HandHeldLegend/GC-Ultimate/HW/Projects/Trigger Hall FPC/FPC_Trigger_Board.kicad_pcb

## KiCad design HW/Projects/Trigger Hall FPC/FPC_Trigger_Board.kicad_pcb (2025-12-12)

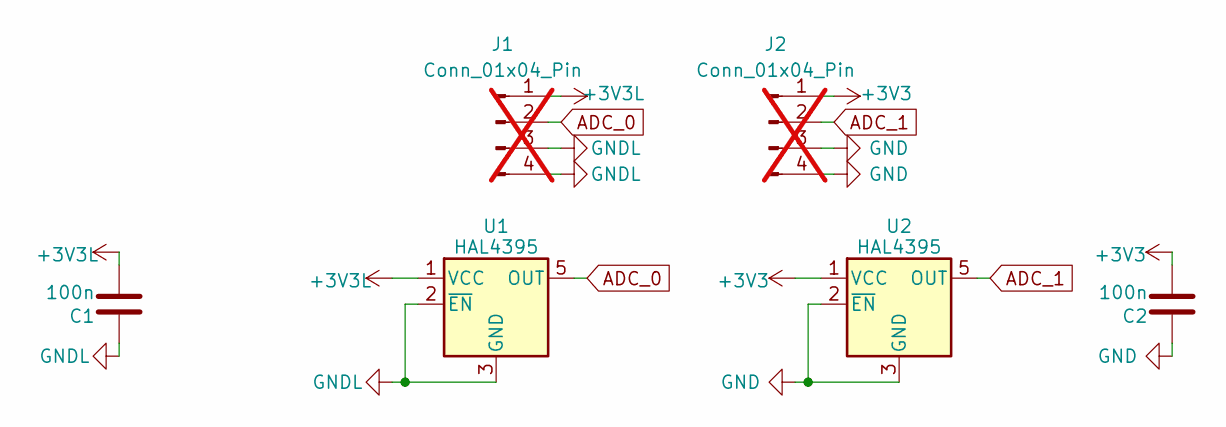
[picture p9: schematic FPC_Trigger_Board.kicad_sch, GCU Hall Trigger]

Parts:
C1, C2: 100n; C_0201_0603Metric; MPN GRM033R61A104KE15D; LCSC C76934
J1, J2: Conn_01x04_Pin; 505110-0492 Ribbon; not fitted
U1, U2: HAL4395; SOT-23-5L; MPN HAL4395SO5; LCSC C49165022

Connections:
+3V3: C2.2, J2.1, U2.1 (VCC)
+3V3L: C1.2, J1.1, U1.1 (VCC)
ADC_0: J1.2, U1.5 (OUT)
ADC_1: J2.2, U2.5 (OUT)
GND: C2.1, J2.3, J2.4, U2.2 (~EN), U2.3 (GND)
GNDL: C1.1, J1.3, J1.4, U1.2 (~EN), U1.3 (GND)

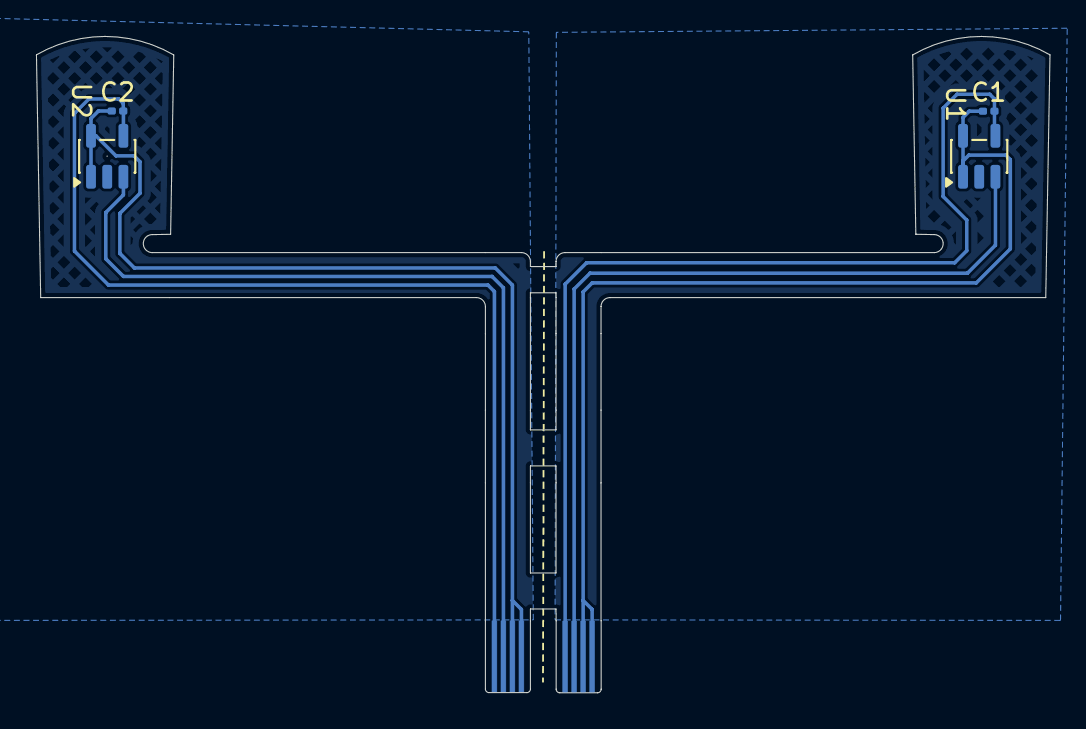
[picture p10: board FPC_Trigger_Board.kicad_pcb from below]

Board: 2 copper layers, 56.3 x 36.5 mm, 6 parts (4 on the bottom side), 6 nets.
