HandHeldLegend/GC-Ultimate/HW/Projects/Main_R4K/UGC_Main_R4K.kicad_pcb

## KiCad design HW/Projects/Main_R4K/UGC_Main_R4K.kicad_pcb (2025-09-02)

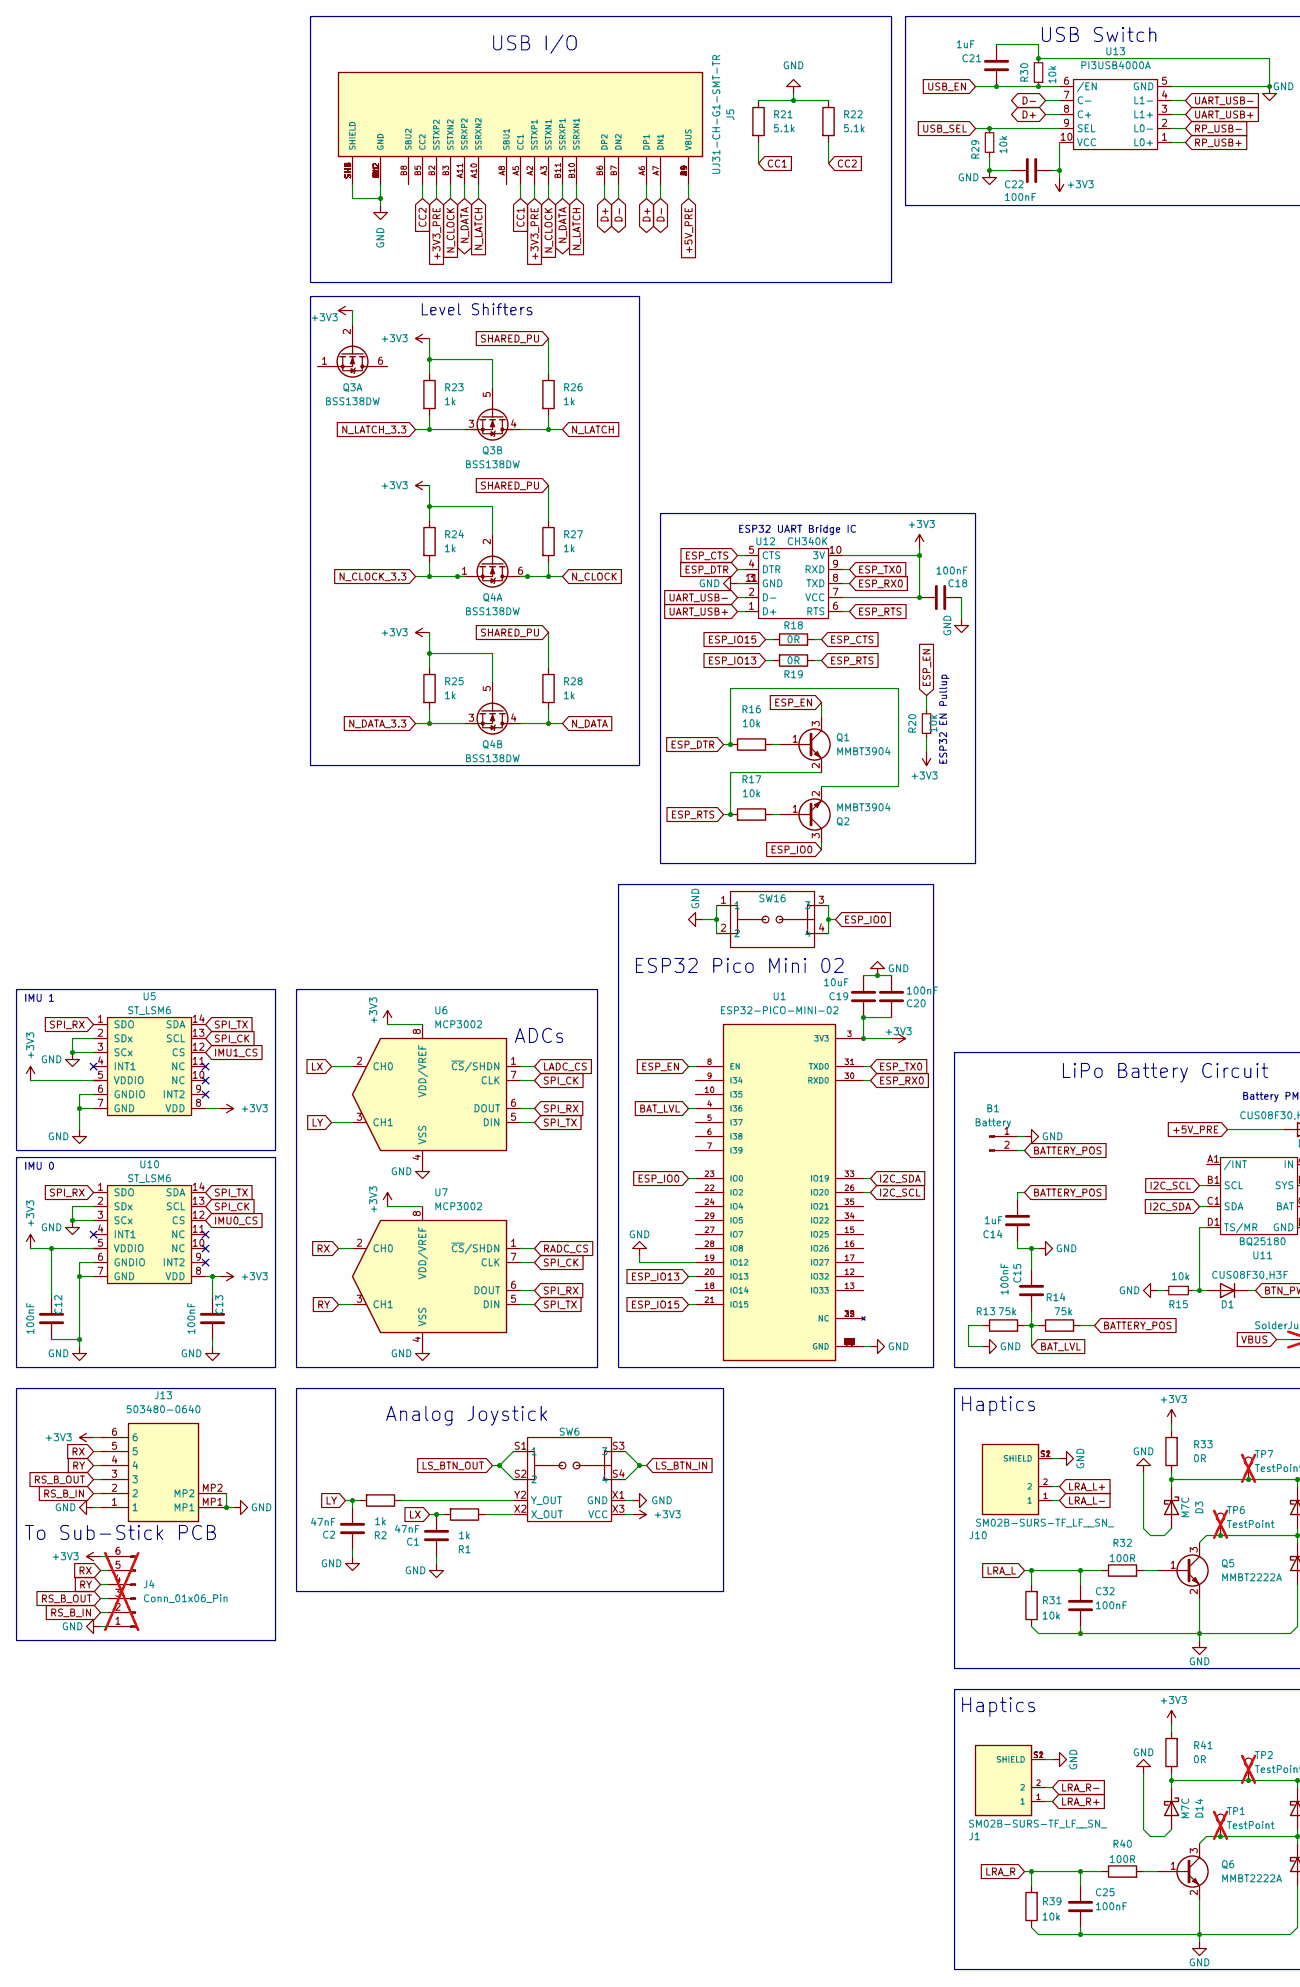
[picture p11: schematic UGC_Main_R4K.kicad_sch, GC Ultimate R4K, part in row 1, column 1]

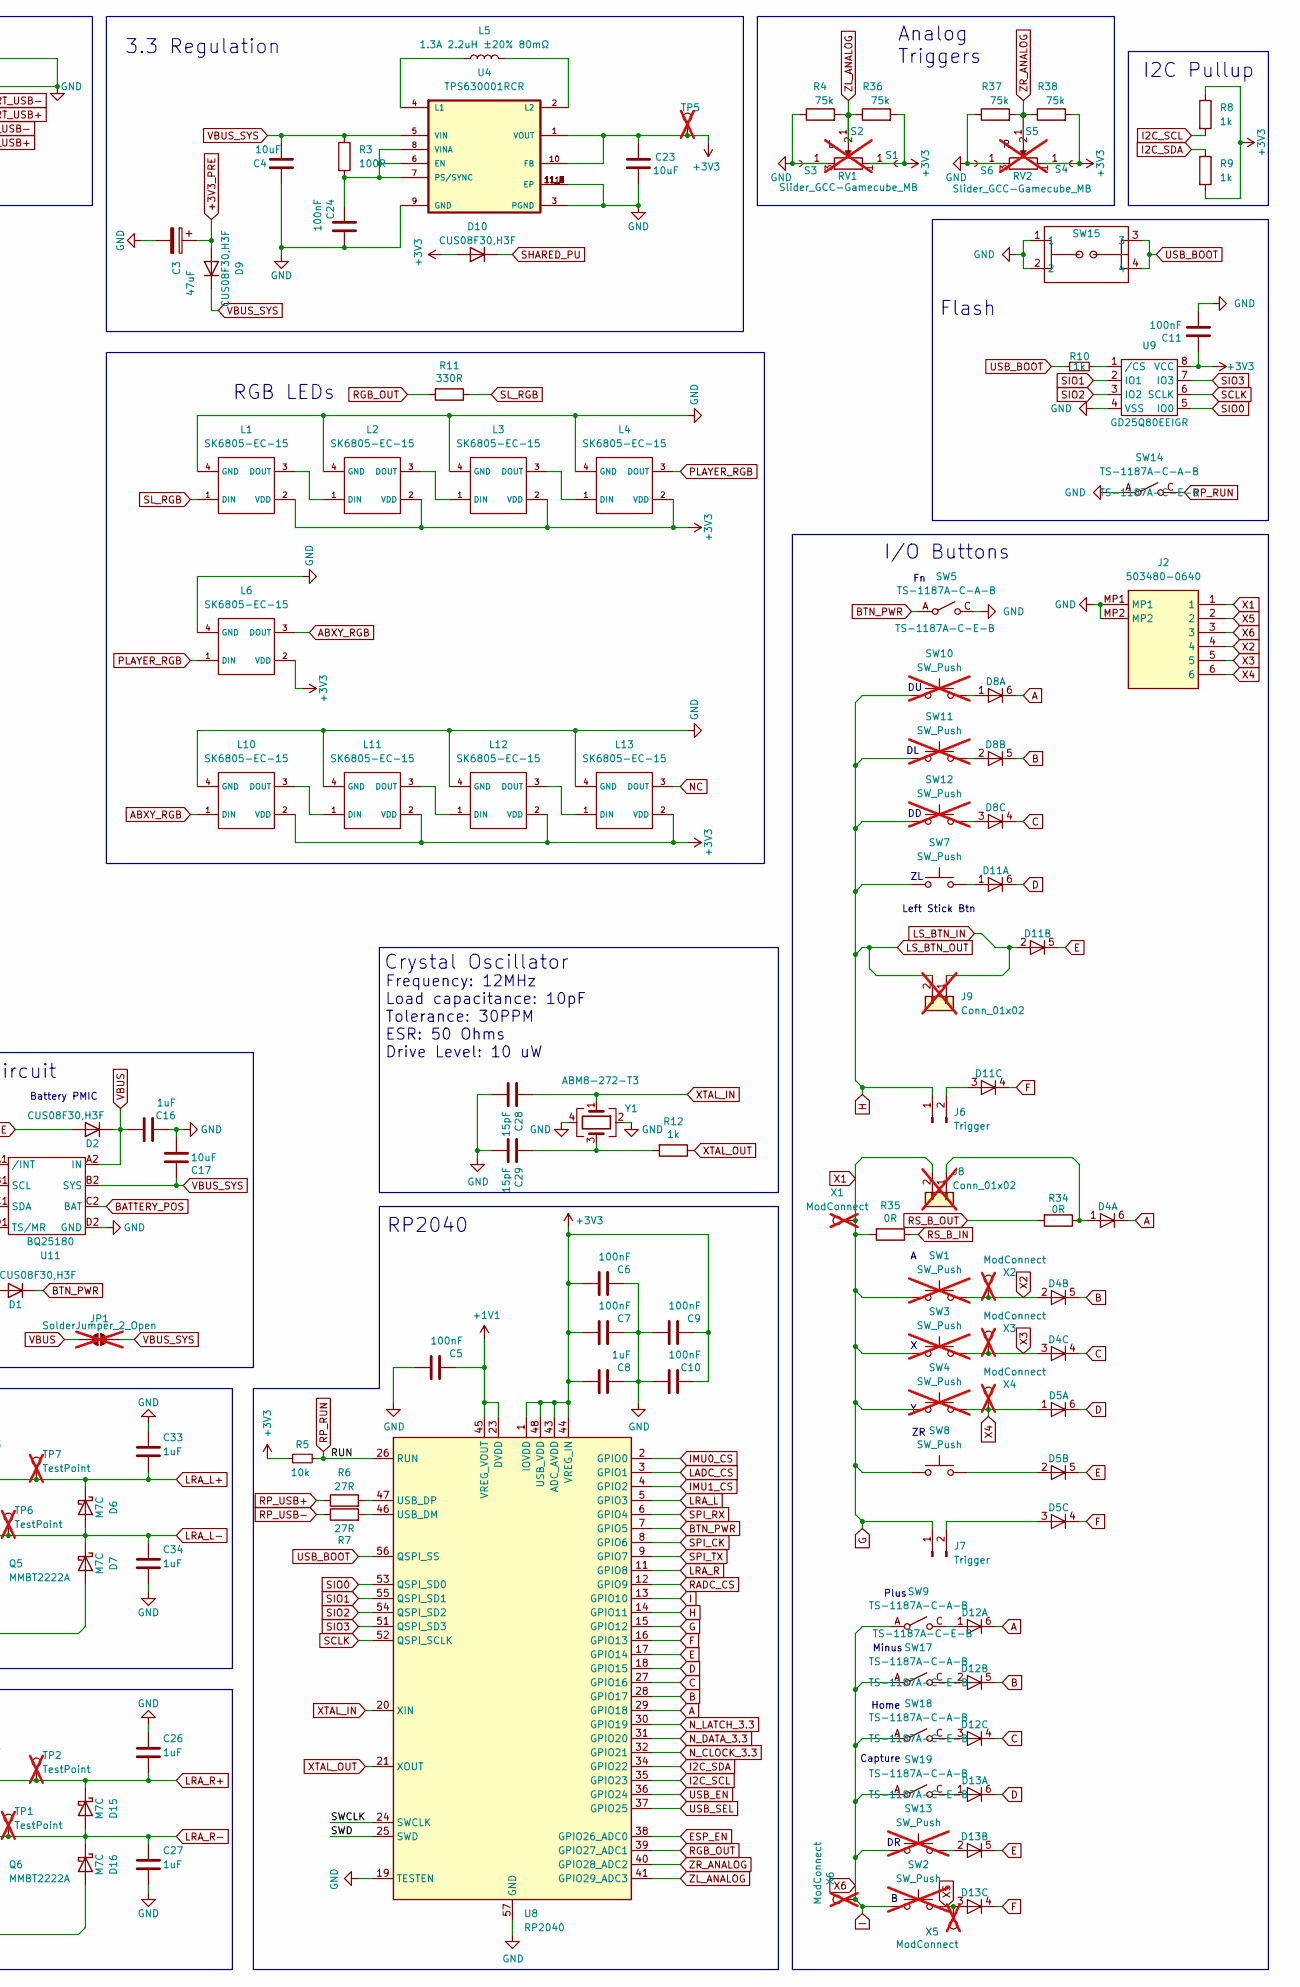
[picture p12: schematic UGC_Main_R4K.kicad_sch, GC Ultimate R4K, part in row 1, column 2]

Parts:
B1: Battery; JST_PH_B2B-PH-K_1x02_P2.00mm_Vertical; MPN HDGC2001WV-2P; LCSC C5175230
C1, C2: 47nF; C_0603_1608Metric; MPN CC0603JRX7R9BB473; LCSC C519554
C3: 47uF; CP_EIA-3216-18_Kemet-A; MPN TAJA476K006RNJ; LCSC C7190
C4, C17, C19, C23: 10uF; C_0805_2012Metric; MPN CL21A106KPFNNNE; LCSC C17024
C5, C6, C7, C9, C10, C11, C12, C13, C15, C18, C20, C22, C24, C25, C32: 100nF; C_0201_0603Metric; MPN CL03A104KQ3NNNC; LCSC C160831
C8, C14, C16, C21, C26, C27, C33, C34: 1uF; C_0201_0603Metric; MPN GRM033R60J105KEA2D; LCSC C76929
C28, C29: 15pF; C_0402_1005Metric; MPN CC0402FRNPO9BN150; LCSC C326803
D1, D2, D9, D10: CUS08F30,H3F; D_SOD-323_HandSoldering; MPN CUS08F30,H3F; LCSC C150183
D3, D6, D7, D14, D15, D16: M7C; D_SOD-523; MPN B5819WT; LCSC C5364321
D4, D5, D8, D11, D12, D13: BAS16VY,115; SOT-363_SC-70-6; MPN BAS16VY,115; LCSC C135826
J1, J10: SM02B-SURS-TF_LF__SN_; JST_SM02B-SURS-TF_LF__SN_; PARTREV N/A; LCSC C566239
J2, J13: 503480-0640; 5034800640; Mouser Part Number 538-503480-0640
J4: Conn_01x06_Pin; PinHeader_1x06_P2.00mm_Vertical; MPN N/A; not fitted
J5: UJ31-CH-G1-SMT-TR; CUI_UJ31-CH-G1-SMT-TR; PART_REV 1.01; LCSC C22359729
J6, J7: Trigger; JST_PH_B2B-PH-K_1x02_P2.00mm_Vertical; MPN HDGC2001WV-2P; LCSC C5175230
J8, J9: Conn_01x02; PinHeader_1x02_P2.00mm_Vertical; MPN N/A; not fitted
JP1: SolderJumper_2_Open; SolderJumper-2_P1.3mm_Open_Pad1.0x1.5mm; MPN N/A; not fitted
L1, L2, L3, L4, L6, L10, L11, L12, L13: SK6805-EC-15; MPN SK6805-EC-15; LCSC C2890035
L5: 1.3A 2.2uH ±20% 80mΩ; L_1008_2520Metric; MPN MIP25202R2MBE; LCSC C315721
Q1, Q2: MMBT3904; SOT-23; MPN MMBT3904; LCSC C2891808
Q3, Q4: BSS138DW; SOT-363_SC-70-6; MPN BSS138DW-7-F; LCSC C154900
Q5, Q6: MMBT2222A; SOT-23; MPN MMBT2222A; LCSC C916372
R1, R2, R8, R9, R10, R12, R23, R24, R25, R26, R27, R28: 1k; R_0201_0603Metric; MPN RC0201FR-071KL; LCSC C138165
R3, R32, R40: 100R; R_0201_0603Metric; MPN RC0201FR-07100RL; LCSC C77623
R4, R13, R14, R36, R37, R38: 75k; R_0201_0603Metric; MPN AF0201FR-0775KL; LCSC C2107901
R5, R15, R16, R17, R20, R29, R30, R31, R39: 10k; R_0201_0603Metric; MPN RC0201FR-0710KL; LCSC C106225
R6, R7: 27R; R_0201_0603Metric; MPN RC0201FR-0727RL; LCSC C273268
R11: 330R; R_0201_0603Metric; MPN RC0201FR-07330RL; LCSC C274872
R18, R19, R33, R34, R35, R41: 0R; R_0201_0603Metric; MPN RC0201FR-070RL; LCSC C106227
R21, R22: 5.1k; R_0201_0603Metric; MPN RC0201FR-075K1L; LCSC C274341
RV1, RV2: Slider_GCC-Gamecube_MB; GCC_Slider_MillMaxSocketed; MPN RD7091008A; not fitted
S1, S2, S3, S4, S5, S6: 4015-0-43-80-30-27-10-0; MPN 4015-0-43-80-30-27-10-0; LCSC C17526581
SW1, SW2, SW3, SW4: SW_Push; ring_pad; MPN N/A; not fitted
SW5, SW9, SW14, SW17, SW18, SW19: TS-1187A-C-A-B; TS-1187A-C-E-B; MPN TS-1187A-C-E-B; LCSC C480267
SW6: GL18_SW; GL1807SYAE; MPN GL1807SYAE-002
SW7, SW8: SW_Push; Z_Switch_Edge_Omron; MPN TC-00100V H5.0 100gf
SW10, SW11, SW12, SW13: SW_Push; ring_dpad; MPN N/A; not fitted
SW15, SW16: 1TS026A-1000-0550; MPN 1TS026A-1000-0550; LCSC C913778
TP1, TP2, TP6, TP7: TestPoint; TestPoint_Pad_2.0x2.0mm; MPN N/A; not fitted
TP5: TestPoint; TestPoint_Pad_D1.5mm; MPN N/A; not fitted
U1: ESP32-PICO-MINI-02; MODULE_ESP32-PICO-MINI-02; PARTREV v1.0; LCSC C2980306
U4: TPS630001RCR; VREG_V62_16624-01YE; MPN TPS63001DRCR; LCSC C28060
U5, U10: ST_LSM6; LGA14; MPN LSM6DSRTR; LCSC C784817
U6, U7: MCP3002; MSOP-8_3x3mm_P0.65mm; MPN MCP3002-I/MS; LCSC C635958
U8: RP2040; QFN-56-1EP_7x7mm_P0.4mm_EP3.2x3.2mm; MPN RP2040; LCSC C2040
U9: GD25Q80EEIGR; USON-8-EP(2x3); MPN GD25Q80EEIGR; LCSC C2874937
U11: BQ25180; DSBGA; MPN BQ25180; LCSC C3682423
U12: CH340K; ESSOP-10; MPN CH340K; LCSC C968586
U13: PI3USB4000A; Texas_UQFN-10_1.5x2mm_P0.5mm; MPN PI3USB4000AZUAEX; LCSC C294596
X1, X2, X3, X4, X5, X6: ModConnect; TestPoint_Pad_D1.5mm; MPN N/A; not fitted
Y1: ABM8-272-T3; Crystal_SMD_3225-4Pin_3.2x2.5mm; MPN ABM8-272-T3; LCSC C20625731

Connections:
+1V1: C5.2, U8.23 (DVDD), U8.45 (VREG_VOUT), U8.50 (DVDD)
+3V3: C6.1, C7.1, C8.1, C9.2, C10.2, C11.1, C12.2, C13.2, C18.1, C19.1, C20.2, C22.1, C23.1, D10.2 (A), J4.6, J13.6, L1.2 (VDD), L2.2 (VDD), L3.2 (VDD), L4.2 (VDD), L6.2 (VDD), L10.2 (VDD), L11.2 (VDD), L12.2 (VDD), L13.2 (VDD), Q3.2 (G1), Q3.5 (G2), Q4.2 (G1), Q4.5 (G2), R5.1, R8.1, R9.2, R20.1, R23.1, R24.1, R25.1, R33.2, R36.2, R38.2, R41.2, S1.1, S4.1, SW6.X3 (VCC), SW6.Y3 (VCC), TP5.1, U1.3 (3V3), U4.1 (VOUT), U4.10 (FB), U5.5 (VDDIO), U5.8 (VDD), U6.8 (VDD/VREF), U7.8 (VDD/VREF), U8.1 (IOVDD), U8.10 (IOVDD), U8.22 (IOVDD), U8.33 (IOVDD), U8.42 (IOVDD), U8.43 (ADC_AVDD), U8.44 (VREG_IN), U8.48 (USB_VDD), U8.49 (IOVDD), U9.8 (VCC), U10.5 (VDDIO), U10.8 (VDD), U12.7 (VCC), U12.10 (3V), U13.10 (VCC)
+3V3_PRE: C3.1, D9.2 (A), J5.A2 (SSTXP1), J5.B2 (SSTXP2)
+5V_PRE: D2.2 (A), J5.A4 (VBUS), J5.A9 (VBUS), J5.B4 (VBUS), J5.B9 (VBUS)
/SWCLK: U8.24 (SWCLK)
/SWD: U8.25 (SWD)
A: D4.6 (K), D8.6 (K), D12.6 (K), U8.29 (GPIO18)
ABXY_RGB: L6.3 (DOUT), L10.1 (DIN)
B: D4.5 (K), D8.5 (K), D12.5 (K), U8.28 (GPIO17)
BATTERY_POS: B1.2, C14.2, R14.2, U11.C2 (BAT)
BAT_LVL: C15.1, R13.2, R14.1, U1.4 (I36)
BTN_PWR: D1.1 (K), SW5.A, SW5.B, U8.7 (GPIO5)
C: D4.4 (K), D8.4 (K), D12.4 (K), U8.27 (GPIO16)
CC1: J5.A5 (CC1), R21.2
CC2: J5.B5 (CC2), R22.2
D: D5.6 (K), D11.6 (K), D13.6 (K), U8.18 (GPIO15)
D+: J5.A6 (DP1), J5.B6 (DP2), U13.8 (C+)
D-: J5.A7 (DN1), J5.B7 (DN2), U13.7 (C-)
E: D5.5 (K), D11.5 (K), D13.5 (K), U8.17 (GPIO14)
ESP_CTS: R18.2, U12.5 (CTS)
ESP_DTR: Q2.2 (E), R16.1, U12.4 (DTR)
ESP_EN: Q1.3 (C), R20.2, U1.8 (EN), U8.38 (GPIO26_ADC0)
ESP_IO0: Q2.3 (C), SW16.3, SW16.4, U1.23 (IO0)
ESP_IO13: R19.2, U1.20 (IO13)
ESP_IO15: R18.1, U1.21 (IO15)
ESP_RTS: Q1.2 (E), R17.2, R19.1, U12.6 (RTS)
ESP_RX0: U1.30 (RXD0), U12.8 (TXD)
ESP_TX0: U1.31 (TXD0), U12.9 (RXD)
F: D5.4 (K), D11.4 (K), D13.4 (K), U8.16 (GPIO13)
G: J2.1, J7.1, J8.2, R35.2, SW1.1, SW3.1, SW4.1, SW8.1, U8.15 (GPIO12), X1.1
GND: B1.1, C1.1, C2.1, C3.2, C4.1, C5.1, C6.2, C7.2, C8.2, C9.1, C10.1, C11.2, C12.1, C13.1, C14.1, C15.2, C16.2, C17.1, C18.2, C19.2, C20.1, C21.2, C22.2, C23.2, C24.1, C25.2, C26.1, C27.2, C28.2, C29.2, C32.2, C33.1, C34.2, D3.2 (A), D7.2 (A), D14.2 (A), D16.2 (A), J1.S1 (SHIELD), J1.S2 (SHIELD), J2.MP1, J2.MP2, J4.1, J5.A1 (GND), J5.A12 (GND), J5.B1 (GND), J5.B12 (GND), J5.SH1 (SHIELD), J5.SH2 (SHIELD), J5.SH3 (SHIELD), J5.SH4 (SHIELD), J5.SH5 (SHIELD), J5.SH6 (SHIELD), J10.S1 (SHIELD), J10.S2 (SHIELD), J13.1, J13.MP1, J13.MP2, L1.4 (GND), L2.4 (GND), L3.4 (GND), L4.4 (GND), L6.4 (GND), L10.4 (GND), L11.4 (GND), L12.4 (GND), L13.4 (GND), Q5.2 (E), Q6.2 (E), R4.1, R13.1, R15.2, R21.1, R22.1, R29.1, R30.2, R31.1, R37.1, R39.1, S3.1, S6.1, SW5.C, SW5.D, SW6.X1 (GND), SW6.Y1 (GND), SW14.A, SW14.B, SW15.1, SW15.2, SW16.1, SW16.2, U1.1 (GND), U1.2 (GND), U1.11 (GND), U1.14 (GND), U1.19 (IO12), U1.36 (GND), U1.37 (GND), U1.38 (GND), U1.39 (GND), U1.40 (GND), U1.41 (GND), U1.42 (GND), U1.43 (GND), U1.44 (GND), U1.45 (GND), U1.46 (GND), U1.47 (GND), U1.48 (GND), U1.49 (GND), U1.50 (GND), U1.51 (GND), U1.52 (GND), U1.53 (GND), U1.54 (GND), U1.55 (GND), U1.56 (GND), U1.57 (GND), U1.58 (GND), U1.59 (GND), U1.60 (GND), U1.61 (GND), U4.3 (PGND), U4.9 (GND), U4.11 (EP), U4.11_1 (EP), U4.11_2 (EP), U4.11_3 (EP), U4.11_4 (EP), U4.11_5 (EP), U4.11_6 (EP), U4.11_7 (EP), U4.11_8 (EP), U5.2 (SDx), U5.3 (SCx), U5.6 (GNDIO), U5.7 (GND), U6.4 (VSS), U7.4 (VSS), U8.19 (TESTEN), U8.57 (GND), U9.4 (VSS), U10.2 (SDx), U10.3 (SCx), U10.6 (GNDIO), U10.7 (GND), U11.D2 (GND), U12.3 (GND), U12.11 (GND), U13.5 (GND), Y1.2, Y1.4
H: J6.1, J9.2, SW6.S1 (1), SW6.S2 (2), SW7.1, SW10.1, SW11.1, SW12.1, U8.14 (GPIO11)
I: J2.3, SW2.1, SW9.A, SW9.B, SW13.1, SW17.A, SW17.B, SW18.A, SW18.B, SW19.A, SW19.B, U8.13 (GPIO10), X6.1
I2C_SCL: R8.2, U1.26 (IO20), U8.35 (GPIO23), U11.B1 (SCL)
I2C_SDA: R9.1, U1.33 (IO19), U8.34 (GPIO22), U11.C1 (SDA)
IMU0_CS: U8.2 (GPIO0), U10.12 (CS)
IMU1_CS: U5.12 (CS), U8.4 (GPIO2)
LADC_CS: U6.1 (~CS/SHDN), U8.3 (GPIO1)
LRA_L: C32.1, R31.2, R32.1, U8.5 (GPIO3)
LRA_L+: C33.2, D3.1 (K), D6.1 (K), J10.2, R33.1, TP7.1
LRA_L-: C34.1, D6.2 (A), D7.1 (K), J10.1, Q5.3 (C), TP6.1
LRA_R: C25.1, R39.2, R40.1, U8.11 (GPIO8)
LRA_R+: C26.2, D14.1 (K), D15.1 (K), J1.1, R41.1, TP2.1
LRA_R-: C27.1, D15.2 (A), D16.1 (K), J1.2, Q6.3 (C), TP1.1
LS_BTN_IN: D11.2 (A), J9.1, SW6.S3 (3), SW6.S4 (4)
LX: C1.2, R1.2, U6.2 (CH0)
LY: C2.2, R2.2, U6.3 (CH1)
NC: L13.3 (DOUT)
N_CLOCK: J5.A3 (SSTXN1), J5.B3 (SSTXN2), Q4.6 (D1), R27.2
N_CLOCK_3.3: Q4.1 (S1), R24.2, U8.32 (GPIO21)
N_DATA: J5.A11 (SSRXP2), J5.B11 (SSRXP1), Q4.4 (S2), R28.2
N_DATA_3.3: Q4.3 (D2), R25.2, U8.31 (GPIO20)
N_LATCH: J5.A10 (SSRXN2), J5.B10 (SSRXN1), Q3.4 (S2), R26.2
N_LATCH_3.3: Q3.3 (D2), R23.2, U8.30 (GPIO19)
unnamed: C29.1, R12.2, Y1.3
unnamed: D1.2 (A), R15.1, U11.D1 (TS/MR)
unnamed: D4.1 (A), J8.1, R34.1
unnamed: D5.2 (A), SW8.2
unnamed: D5.3 (A), J7.2
unnamed: D8.1 (A), SW10.2
unnamed: D8.2 (A), SW11.2
unnamed: D8.3 (A), SW12.2
unnamed: D11.1 (A), SW7.2
unnamed: D11.3 (A), J6.2
unnamed: D12.1 (A), SW9.C, SW9.D
unnamed: D12.2 (A), SW17.C, SW17.D
unnamed: D12.3 (A), SW18.C, SW18.D
unnamed: D13.1 (A), SW19.C, SW19.D
unnamed: D13.2 (A), SW13.2
unnamed: L1.3 (DOUT), L2.1 (DIN)
unnamed: L2.3 (DOUT), L3.1 (DIN)
unnamed: L3.3 (DOUT), L4.1 (DIN)
unnamed: L10.3 (DOUT), L11.1 (DIN)
unnamed: L11.3 (DOUT), L12.1 (DIN)
unnamed: L12.3 (DOUT), L13.1 (DIN)
unnamed: Q1.1 (B), R16.2
unnamed: Q2.1 (B), R17.1
unnamed: Q5.1 (B), R32.2
unnamed: Q6.1 (B), R40.2
unnamed: R1.1, SW6.X2 (X_OUT)
unnamed: R2.1, SW6.Y2 (Y_OUT)
unnamed: C24.2, R3.2, U4.6 (EN), U4.7 (PS/SYNC), U4.8 (VINA)
unnamed: L5.1, U4.4 (L1)
unnamed: L5.2, U4.2 (L2)
unnamed: R7.2, U8.46 (USB_DM)
unnamed: R6.2, U8.47 (USB_DP)
unnamed: R10.2, U9.1 (/CS)
PLAYER_RGB: L4.3 (DOUT), L6.1 (DIN)
RADC_CS: U7.1 (~CS/SHDN), U8.12 (GPIO9)
RGB_OUT: R11.2, U8.39 (GPIO27_ADC1)
RP_RUN: R5.2, SW14.C, SW14.D, U8.26 (RUN)
RP_USB+: R6.1, U13.1 (L0+)
RP_USB-: R7.1, U13.2 (L0-)
RS_B_IN: J4.2, J13.2, R35.1
RS_B_OUT: J4.3, J13.3, R34.2
RX: J4.5, J13.5, U7.2 (CH0)
RY: J4.4, J13.4, U7.3 (CH1)
SCLK: U8.52 (QSPI_SCLK), U9.6 (SCLK)
SHARED_PU: D10.1 (K), R26.1, R27.1, R28.1
SIO0: U8.53 (QSPI_SD0), U9.5 (IO0)
SIO1: U8.55 (QSPI_SD1), U9.2 (IO1)
SIO2: U8.54 (QSPI_SD2), U9.3 (IO2)
SIO3: U8.51 (QSPI_SD3), U9.7 (IO3)
SL_RGB: L1.1 (DIN), R11.1
SPI_CK: U5.13 (SCL), U6.7 (CLK), U7.7 (CLK), U8.8 (GPIO6), U10.13 (SCL)
SPI_RX: U5.1 (SDO), U6.6 (DOUT), U7.6 (DOUT), U8.6 (GPIO4), U10.1 (SDO)
SPI_TX: U5.14 (SDA), U6.5 (DIN), U7.5 (DIN), U8.9 (GPIO7), U10.14 (SDA)
UART_USB+: U12.1 (D+), U13.3 (L1+)
UART_USB-: U12.2 (D-), U13.4 (L1-)
USB_BOOT: R10.1, SW15.3, SW15.4, U8.56 (QSPI_SS)
USB_EN: C21.1, R30.1, U8.36 (GPIO24), U13.6 (/EN)
USB_SEL: R29.2, U8.37 (GPIO25), U13.9 (SEL)
VBUS: C16.1, D2.1 (K), JP1.1 (A), U11.A2 (IN)
VBUS_SYS: C4.2, C17.2, D9.1 (K), JP1.2 (B), R3.1, U4.5 (VIN), U11.B2 (SYS)
X2: D4.2 (A), J2.4, SW1.2, X2.1
X3: D4.3 (A), J2.5, SW3.2, X3.1
X4: D5.1 (A), J2.6, SW4.2, X4.1
X5: D13.3 (A), J2.2, SW2.2, X5.1
XTAL_IN: C28.1, U8.20 (XIN), Y1.1
XTAL_OUT: R12.1, U8.21 (XOUT)
ZL_ANALOG: R4.2, R36.1, S2.1, U8.41 (GPIO29_ADC3)
ZR_ANALOG: R37.2, R38.1, S5.1, U8.40 (GPIO28_ADC2)

Notes on the sheet:
Left Stick Btn
To Sub-Stick PCB
Minus
RP2040
RGB LEDs
LiPo Battery Circuit
ESP32 EN Pullup
USB I/O
I2C Pullup
USB Switch
Plus
ADCs
Analog Joystick
Haptics
Flash
ESP32 Pico Mini 02
Frequency: 12MHz Load capacitance: 10pF Tolerance: 30PPM ESR: 50 Ohms Drive Level: 10 uW
Crystal Oscillator
ESP32 UART Bridge IC
3.3 Regulation
I/O Buttons
Analog Triggers
IMU 0
Capture
Home
IMU 1
Battery PMIC
Level Shifters

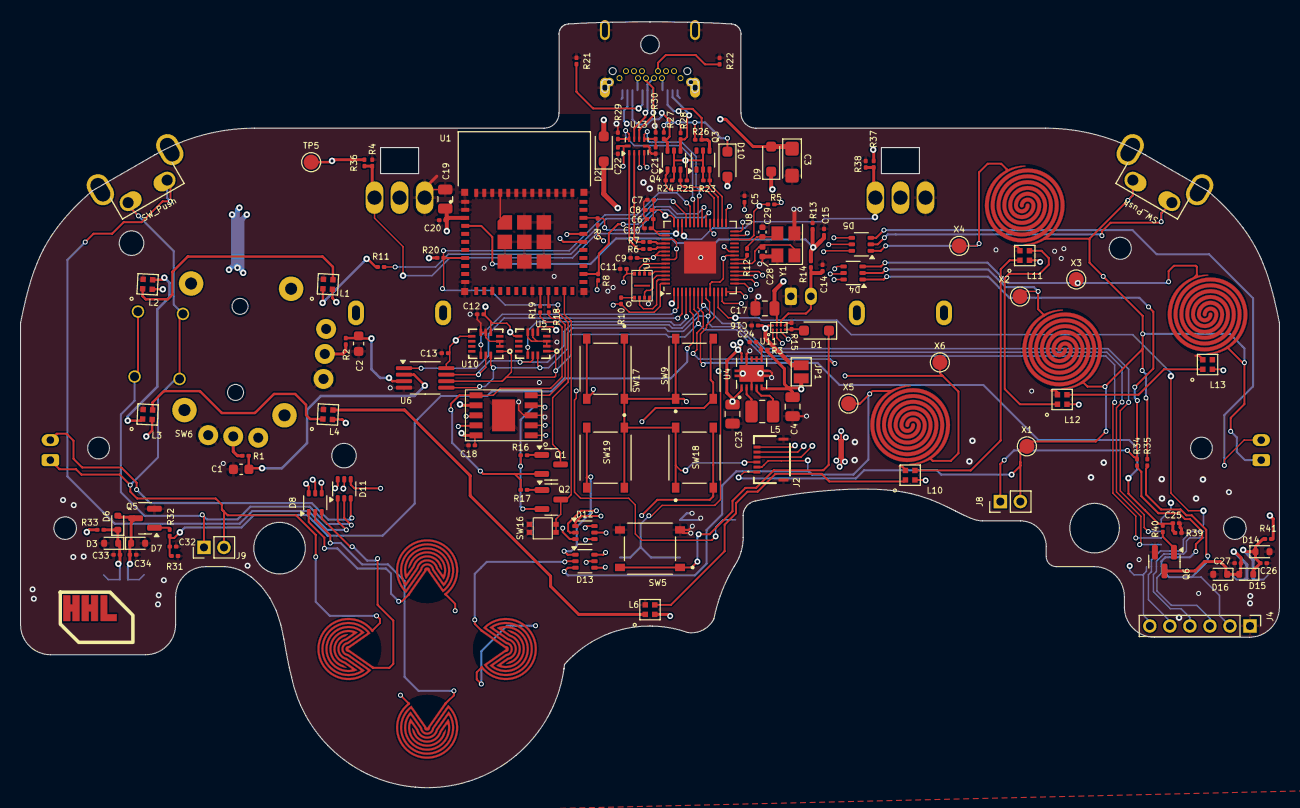
[picture p13: board UGC_Main_R4K.kicad_pcb from above]

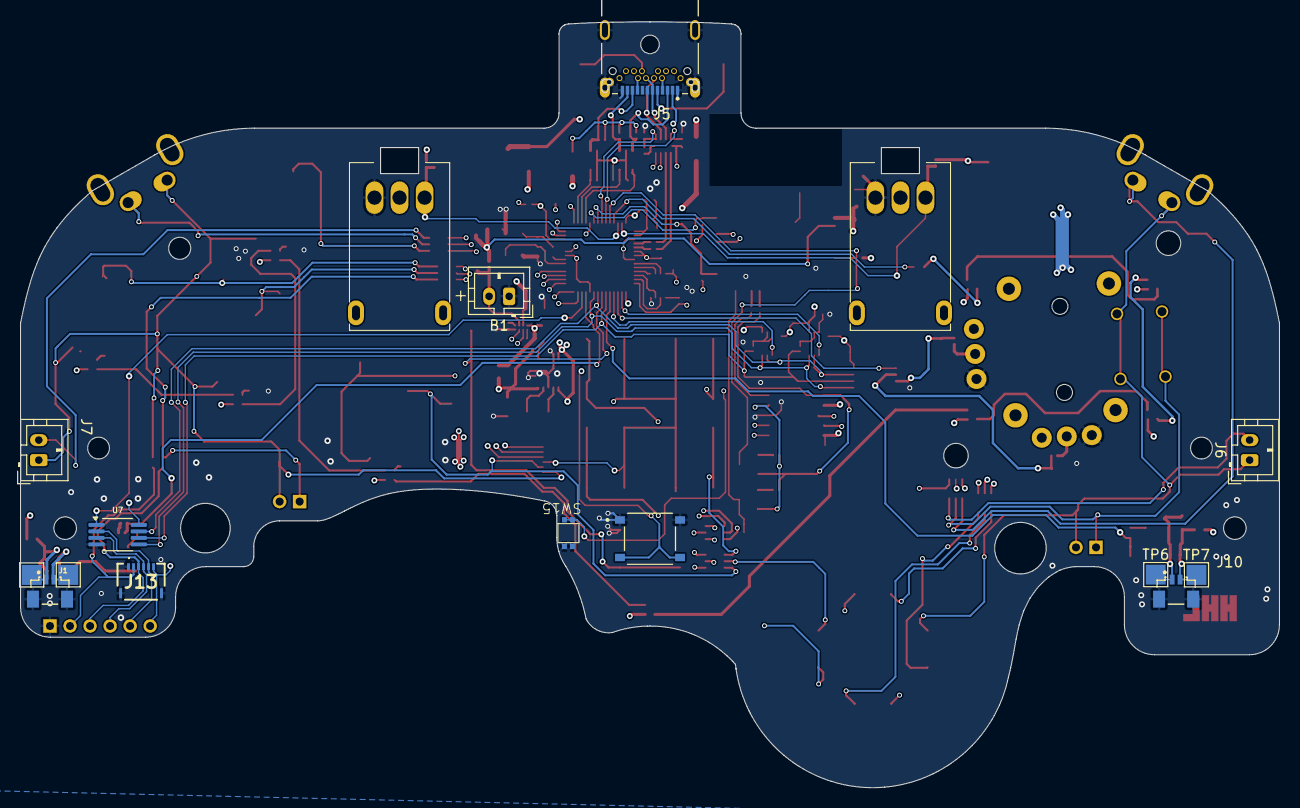
[picture p14: board UGC_Main_R4K.kicad_pcb from below]

Board: 4 copper layers, 125.7 x 76.4 mm, 167 parts (22 on the bottom side), 119 nets.
