HandHeldLegend/GC-Ultimate/HW/Projects/SubStick_R5/UGC_SubStick_R5.kicad_pcb

## KiCad design HW/Projects/SubStick_R5/UGC_SubStick_R5.kicad_pcb (2025-07-21)

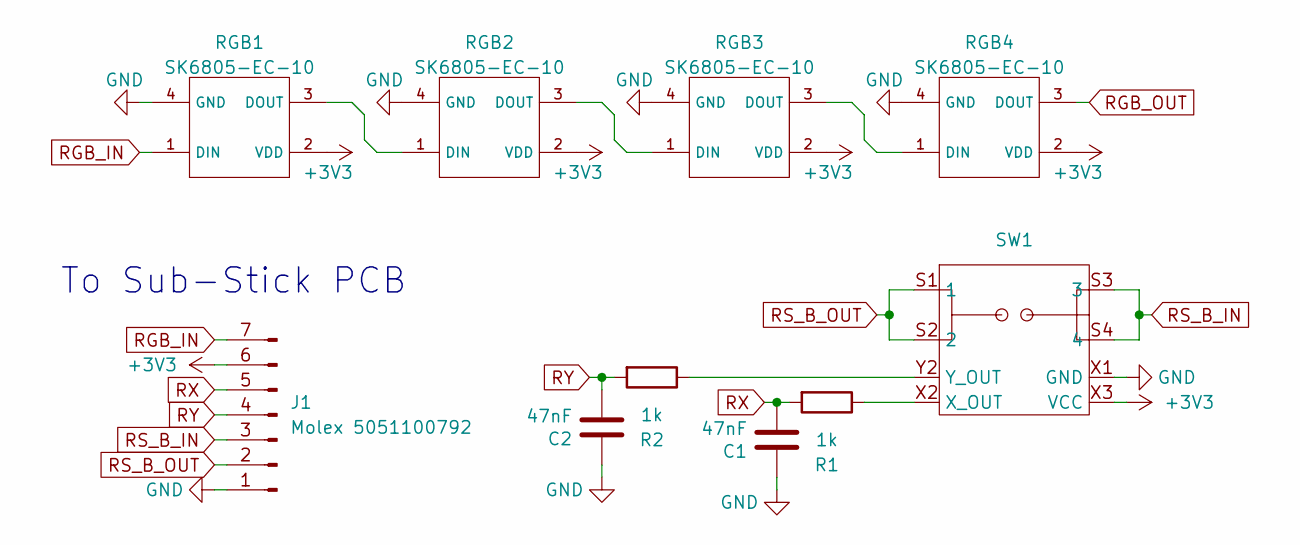
[picture p15: schematic UGC_SubStick_R5.kicad_sch, GC Ultimate C Stick R5]

Parts:
C1, C2: 47nF; C_0603_1608Metric; MPN CC0603JRX7R9BB473; LCSC C519554
J1: Molex 5051100792; CON_5051100792_MOL; MPN 5051100792; LCSC C6689159
R1, R2: 1k; R_0201_0603Metric; MPN RC0201FR-071KL; LCSC C138165
RGB1, RGB2, RGB3, RGB4: SK6805-EC-10; MPN SK6805-EC-10; LCSC C22394946
SW1: GL18_SW; GL1807SYAE; MPN GL1807SYAE-002

Connections:
+3V3: J1.6, RGB1.2 (VDD), RGB2.2 (VDD), RGB3.2 (VDD), RGB4.2 (VDD), SW1.X3 (VCC), SW1.Y3 (VCC)
GND: C1.1, C2.1, J1.1, RGB1.4 (GND), RGB2.4 (GND), RGB3.4 (GND), RGB4.4 (GND), SW1.X1 (GND), SW1.Y1 (GND)
unnamed: RGB1.3 (DOUT), RGB2.1 (DIN)
unnamed: RGB2.3 (DOUT), RGB3.1 (DIN)
unnamed: RGB3.3 (DOUT), RGB4.1 (DIN)
unnamed: R1.1, SW1.X2 (X_OUT)
unnamed: R2.1, SW1.Y2 (Y_OUT)
RGB_IN: J1.7, RGB1.1 (DIN)
RGB_OUT: RGB4.3 (DOUT)
RS_B_IN: J1.3, SW1.S3 (3), SW1.S4 (4)
RS_B_OUT: J1.2, SW1.S1 (1), SW1.S2 (2)
RX: C1.2, J1.5, R1.2
RY: C2.2, J1.4, R2.2

Notes on the sheet:
To Sub-Stick PCB

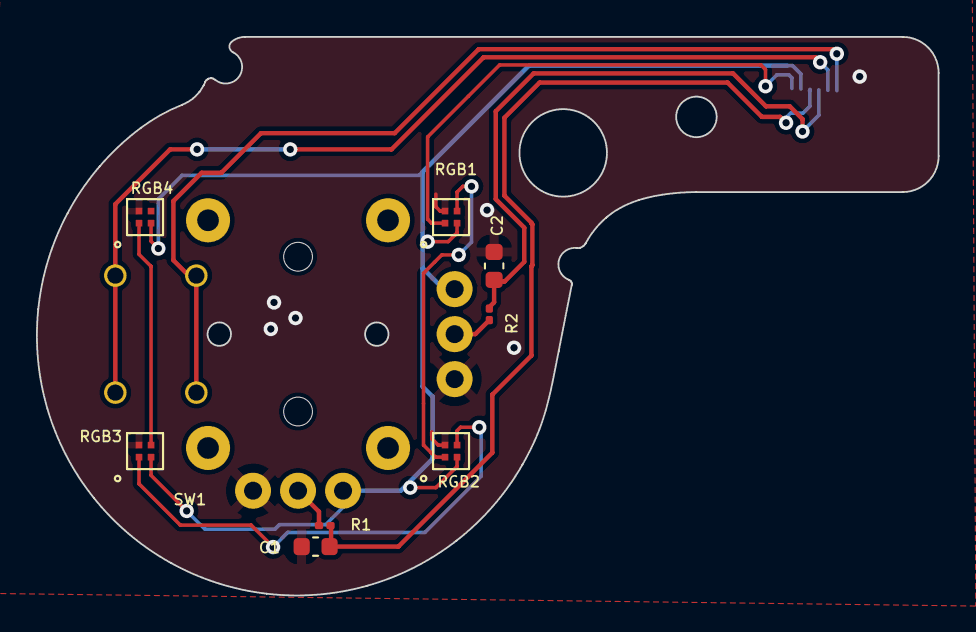
[picture p16: board UGC_SubStick_R5.kicad_pcb from above]

Board: 2 copper layers, 50.1 x 31.0 mm, 10 parts (1 on the bottom side), 12 nets.
