HandHeldLegend/GC-Ultimate/HW/Projects/Trigger/UGC_Trigger.kicad_pcb

## KiCad design HW/Projects/Trigger/UGC_Trigger.kicad_pcb (2024-08-23)

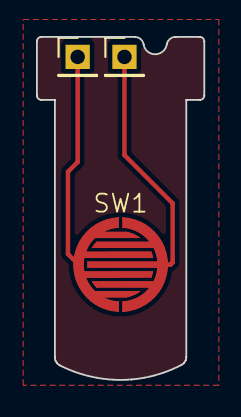
[picture p17: board UGC_Trigger.kicad_pcb from above]

Board: 2 copper layers, 9.3 x 19.1 mm, 3 parts (0 on the bottom side), 2 nets.

Parts:
J1, J2: Conn_01x01_Pin; PinHeader_1x01_P2.00mm_Vertical
SW1: SW_Push; starprint

Connections:
unnamed: J1.1, SW1.2
unnamed: J2.1, SW1.1
