HandHeldLegend/GC-Ultimate/HW/Projects/MechTrigger/UGC_MechTrigger.kicad_pcb

## KiCad design HW/Projects/MechTrigger/UGC_MechTrigger.kicad_pcb (2025-07-19)

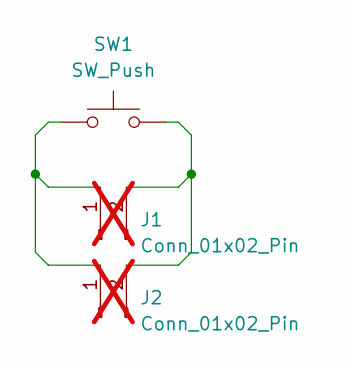
[picture p18: schematic UGC_MechTrigger.kicad_sch, Mechanical Trigger PCB for GC Ultimate]

Parts:
J1, J2: Conn_01x02_Pin; PinHeader_1x02_P2.54mm_Vertical; not fitted
SW1: SW_Push; PG1353; MPN CPG135301D03

Connections:
unnamed: J1.1, J2.1, SW1.1
unnamed: J1.2, J2.2, SW1.2

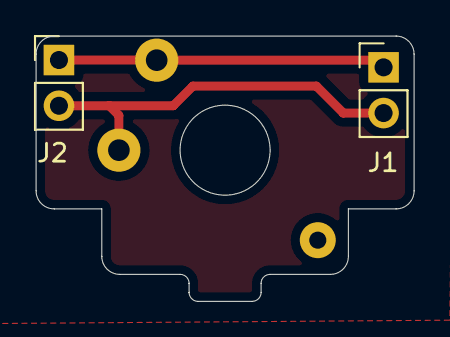
[picture p19: board UGC_MechTrigger.kicad_pcb from above]

Board: 2 copper layers, 21.0 x 14.7 mm, 3 parts (0 on the bottom side), 2 nets.
